SassyDice/RF-Controlled-Robotic-Hand/README.md

# RF Controlled Robotic Hand
 Created for school project using inmoov 3d models. All the necessary explanations are available in the files.
# *
# *
# RF Kontrollü Robotik El
 Inmoov 3d modelleri kullanılarak okul projesi için oluşturuldu. Gerekli tüm açıklamalar dosyalarda mevcuttur.
