SassyDice/RF-Controlled-Robotic-Hand/#Robotic Hand/3D Tasarım/Stl Dosyaları/#Dönebilen Bilek (Alternatif)/rotawrist3V2.stl

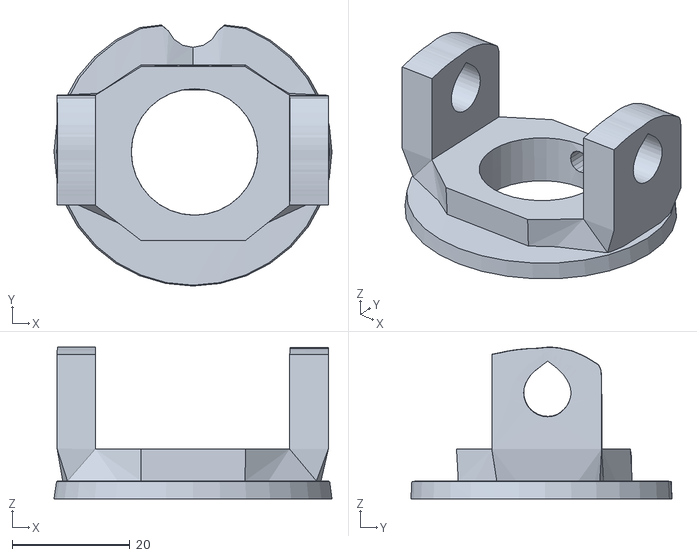
[picture p26: CAD file, 2021-06-02]
#Robotic Hand/3D Tasarım/Stl Dosyaları/#Dönebilen Bilek (Alternatif)/rotawrist3V2.stl
47.2 x 44.3 x 25.7
