SassyDice/RF-Controlled-Robotic-Hand/#Robotic Hand/3D Tasarım/Stl Dosyaları/Avuç İçi/WristlargeV4.stl

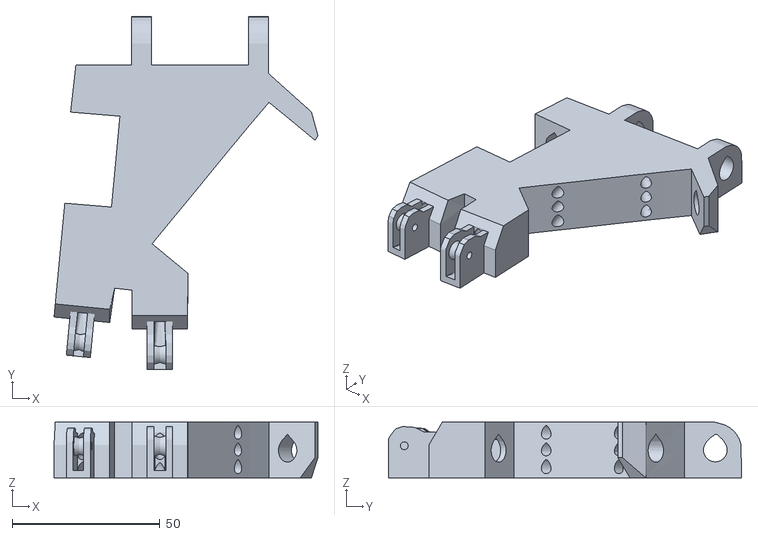
[picture p27: CAD file, 2021-06-02]
#Robotic Hand/3D Tasarım/Stl Dosyaları/Avuç İçi/WristlargeV4.stl
89.2 x 119.4 x 18.9
