SassyDice/RF-Controlled-Robotic-Hand/#Robotic Hand/3D Tasarım/Stl Dosyaları/Dış Kaplama/coverfinger1.stl

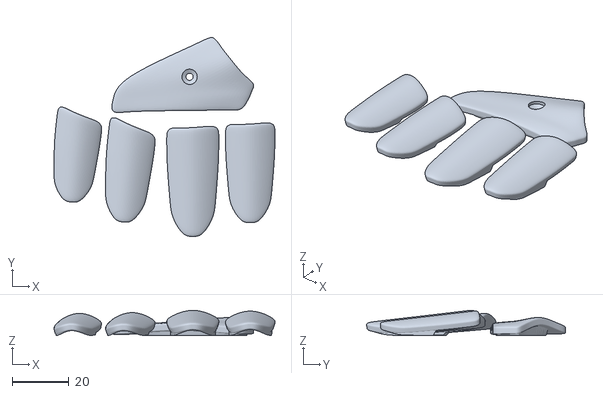
[picture p28: CAD file, 2021-06-02]
#Robotic Hand/3D Tasarım/Stl Dosyaları/Dış Kaplama/coverfinger1.stl
77.7 x 69.9 x 8.87
