SassyDice/RF-Controlled-Robotic-Hand/#Robotic Hand/3D Tasarım/Stl Dosyaları/Kol/robpart4V3.stl

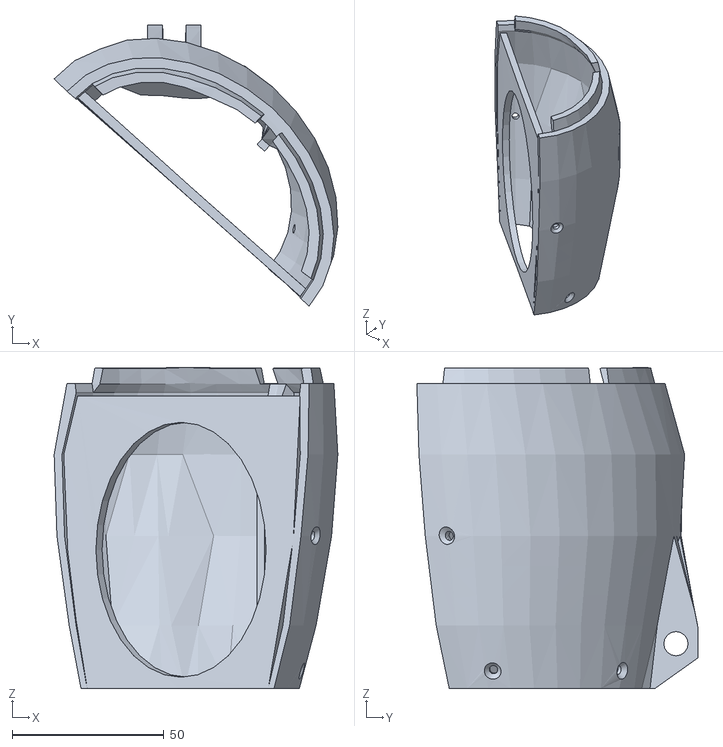
[picture p29: CAD file, 2021-06-02]
#Robotic Hand/3D Tasarım/Stl Dosyaları/Kol/robpart4V3.stl
93.5 x 92.7 x 105.8
