SassyDice/RF-Controlled-Robotic-Hand/#Robotic Hand/3D Tasarım/Stl Dosyaları/Parmaklar/Majeure3.stl

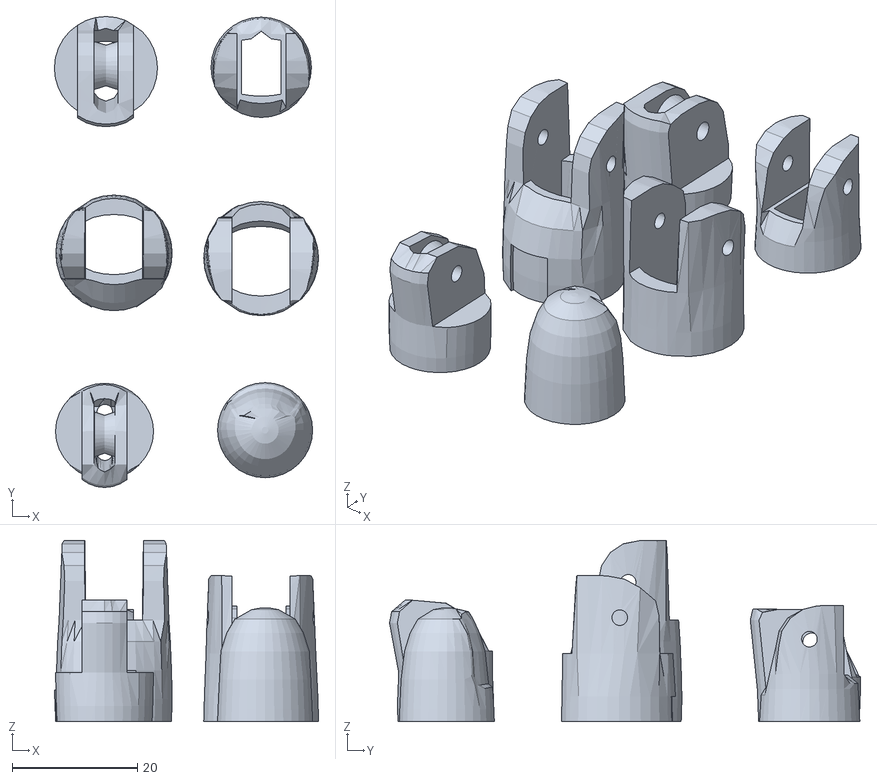
[picture p30: CAD file, 2021-06-02]
#Robotic Hand/3D Tasarım/Stl Dosyaları/Parmaklar/Majeure3.stl
42.2 x 75.2 x 29.0
