SassyDice/RF-Controlled-Robotic-Hand/#Robotic Hand/3D Tasarım/Stl Dosyaları/Çevre Birimler/RobCableBack.stl

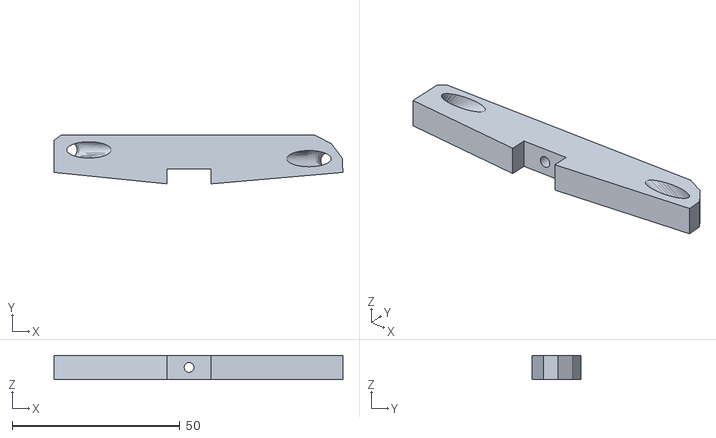
[picture p31: CAD file, 2021-06-02]
#Robotic Hand/3D Tasarım/Stl Dosyaları/Çevre Birimler/RobCableBack.stl
86.1 x 14.5 x 7.17
