SassyDice/RF-Controlled-Robotic-Hand/#Robotic Hand/3D Tasarım/Stl Dosyaları/#Dönebilen Bilek (Alternatif)/WristGearsV4.stl

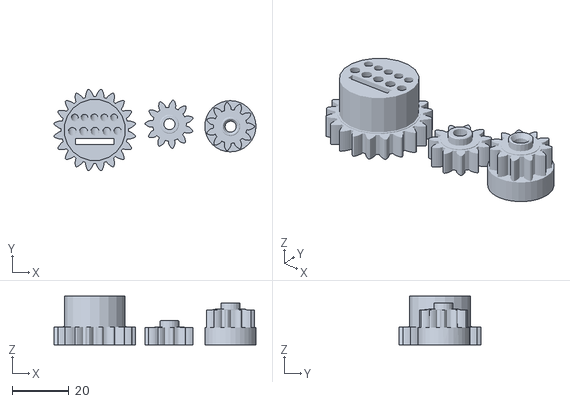
[picture p32: CAD file, 2021-06-02]
#Robotic Hand/3D Tasarım/Stl Dosyaları/#Dönebilen Bilek (Alternatif)/WristGearsV4.stl
71.0 x 28.7 x 17.1
