SassyDice/RF-Controlled-Robotic-Hand/#Robotic Hand/3D Tasarım/Stl Dosyaları/Avuç İçi/WristsmallV3.stl

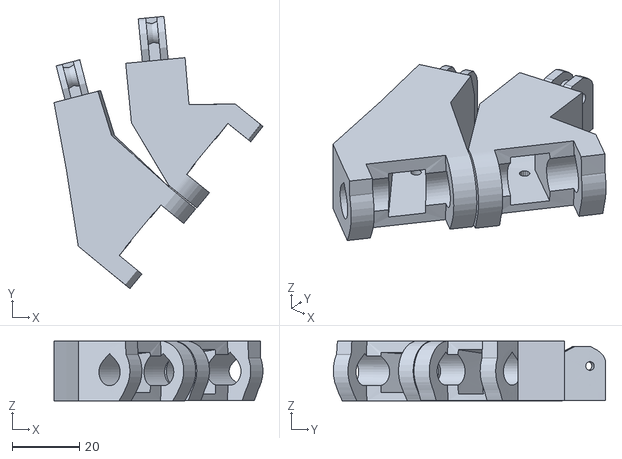
[picture p33: CAD file, 2021-06-02]
#Robotic Hand/3D Tasarım/Stl Dosyaları/Avuç İçi/WristsmallV3.stl
62.0 x 80.8 x 17.7
