SassyDice/RF-Controlled-Robotic-Hand/#Robotic Hand/3D Tasarım/Stl Dosyaları/Dış Kaplama/topsurface4.stl

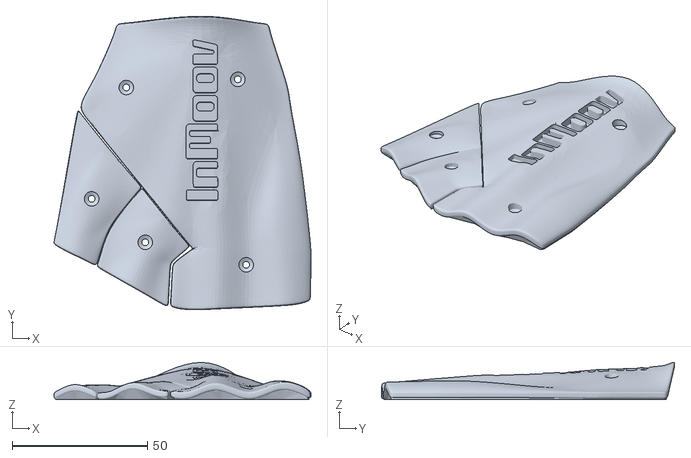
[picture p34: CAD file, 2021-06-02]
#Robotic Hand/3D Tasarım/Stl Dosyaları/Dış Kaplama/topsurface4.stl
94.9 x 108.3 x 13.7
