SassyDice/RF-Controlled-Robotic-Hand/#Robotic Hand/3D Tasarım/Stl Dosyaları/Kol/robpart3V3.stl

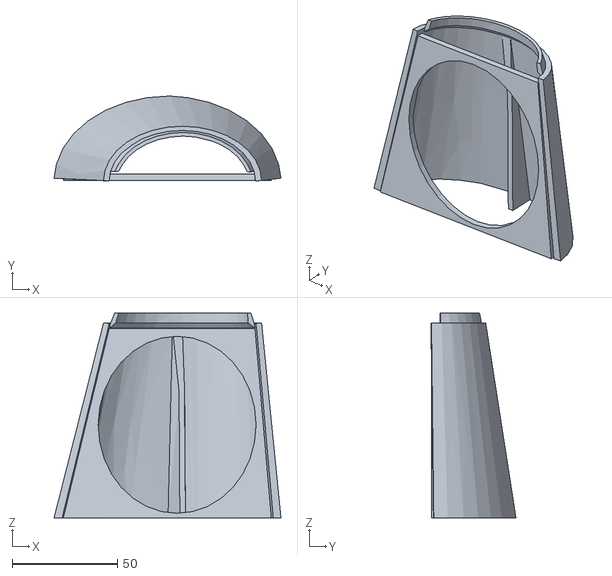
[picture p35: CAD file, 2021-06-02]
#Robotic Hand/3D Tasarım/Stl Dosyaları/Kol/robpart3V3.stl
107.8 x 40.4 x 97.3
