SassyDice/RF-Controlled-Robotic-Hand/#Robotic Hand/3D Tasarım/Stl Dosyaları/Parmaklar/Auriculaire3.stl

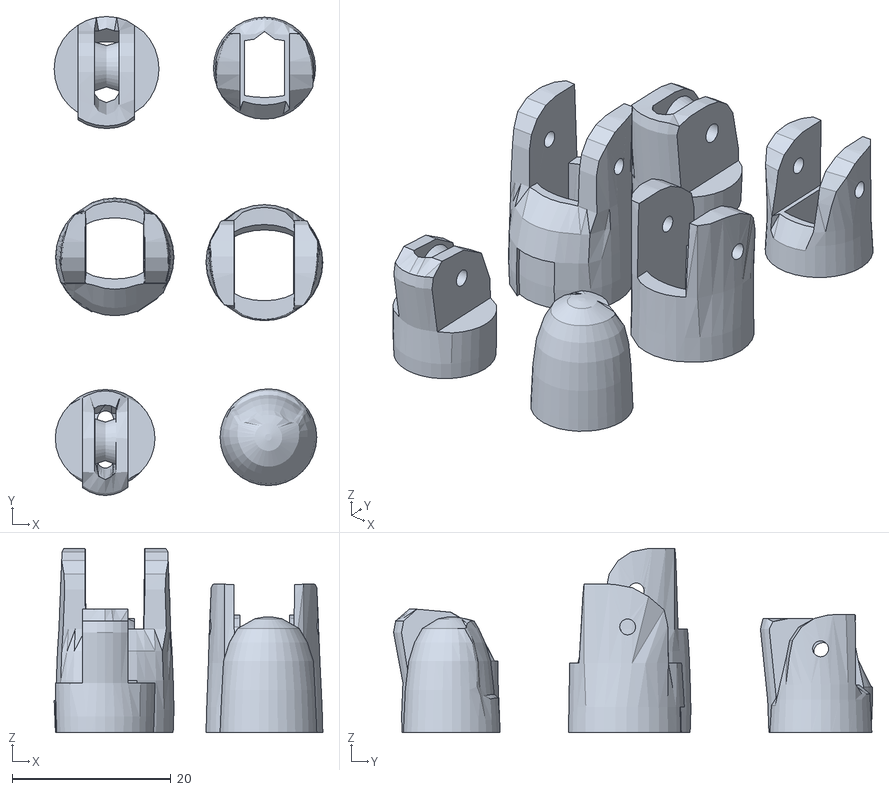
[picture p36: CAD file, 2021-06-02]
#Robotic Hand/3D Tasarım/Stl Dosyaları/Parmaklar/Auriculaire3.stl
33.8 x 60.3 x 23.2
