SassyDice/RF-Controlled-Robotic-Hand/#Robotic Hand/3D Tasarım/Stl Dosyaları/Çevre Birimler/RobRing.stl

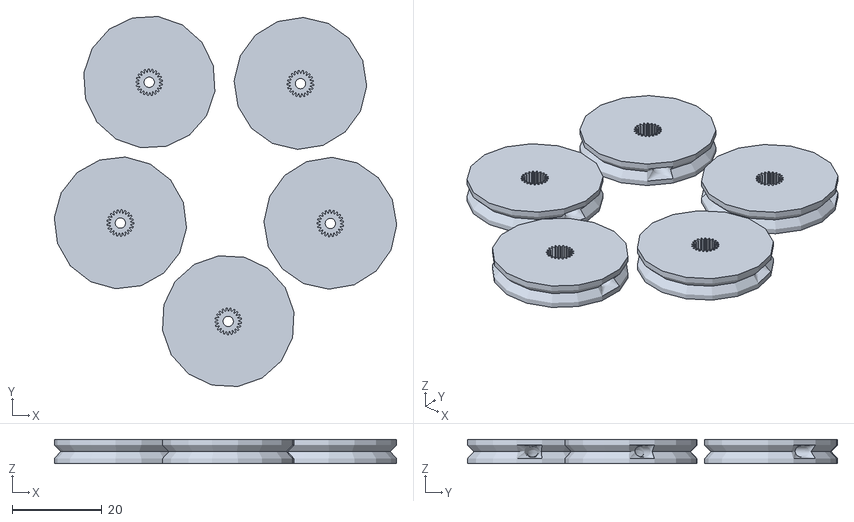
[picture p37: CAD file, 2021-06-02]
#Robotic Hand/3D Tasarım/Stl Dosyaları/Çevre Birimler/RobRing.stl
76.1 x 82.3 x 5.37
