SassyDice/RF-Controlled-Robotic-Hand/#Robotic Hand/3D Tasarım/Stl Dosyaları/#Dönebilen Bilek (Alternatif)/rotawrist1V3.stl

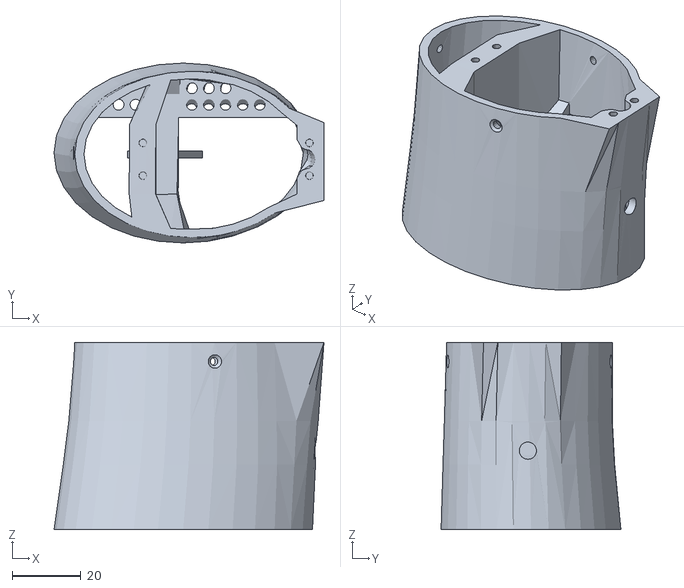
[picture p38: CAD file, 2021-06-02]
#Robotic Hand/3D Tasarım/Stl Dosyaları/#Dönebilen Bilek (Alternatif)/rotawrist1V3.stl
78.4 x 52.2 x 54.4
