SassyDice/RF-Controlled-Robotic-Hand/#Robotic Hand/3D Tasarım/Stl Dosyaları/Kol/robpart2V3.stl

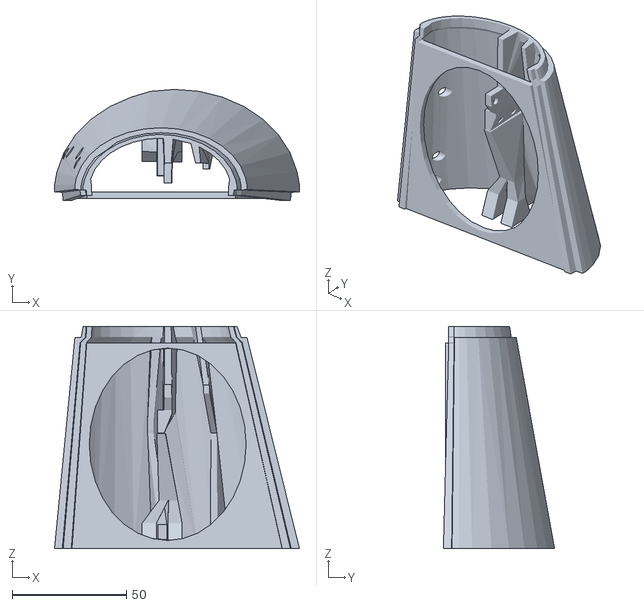
[picture p39: CAD file, 2021-06-02]
#Robotic Hand/3D Tasarım/Stl Dosyaları/Kol/robpart2V3.stl
107.2 x 48.7 x 97.3
