SassyDice/RF-Controlled-Robotic-Hand/#Robotic Hand/3D Tasarım/Stl Dosyaları/Parmaklar/ringfinger3.stl

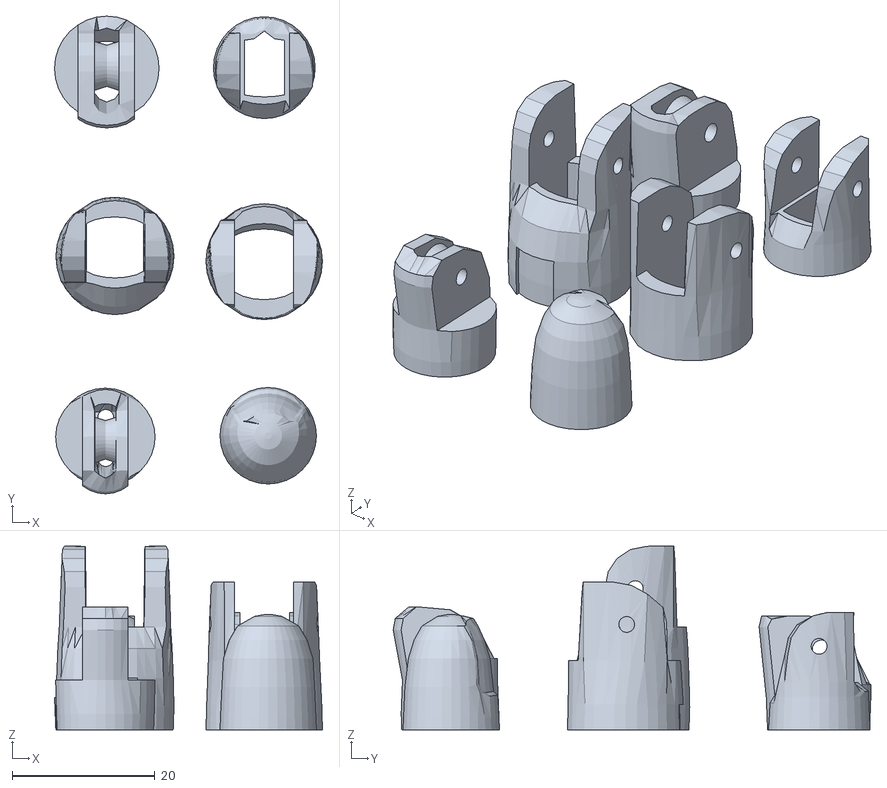
[picture p40: CAD file, 2021-06-02]
#Robotic Hand/3D Tasarım/Stl Dosyaları/Parmaklar/ringfinger3.stl
37.6 x 67.0 x 25.8
