SassyDice/RF-Controlled-Robotic-Hand/#Robotic Hand/3D Tasarım/Stl Dosyaları/Çevre Birimler/ardiuinosupport.stl

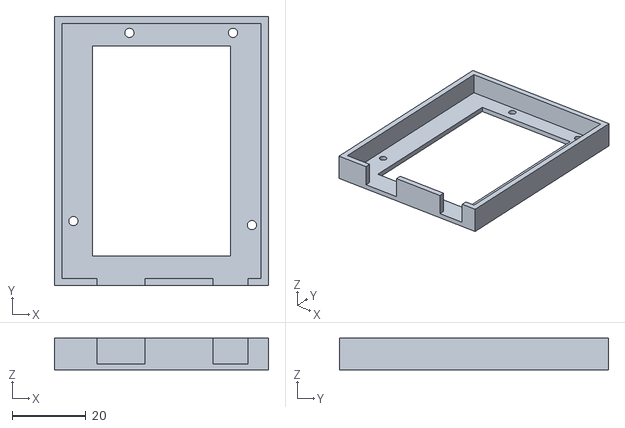
[picture p41: CAD file, 2021-06-02]
#Robotic Hand/3D Tasarım/Stl Dosyaları/Çevre Birimler/ardiuinosupport.stl
58.0 x 73.0 x 8.62
