SassyDice/RF-Controlled-Robotic-Hand/#Robotic Hand/3D Tasarım/Stl Dosyaları/#Dönebilen Bilek (Alternatif)/..robpart1V2 (Non-rotationable).stl

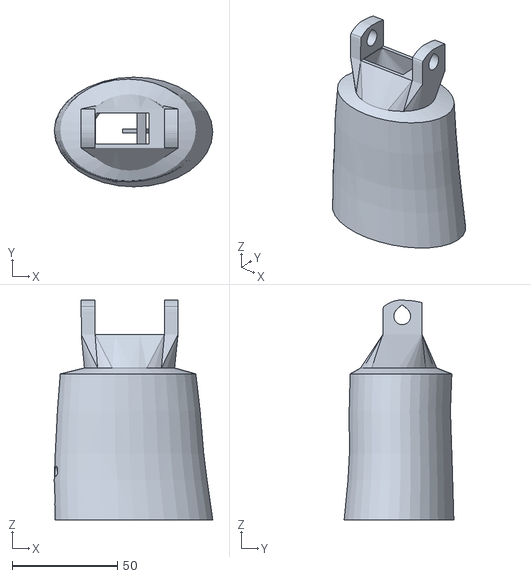
[picture p42: CAD file, 2021-06-02]
#Robotic Hand/3D Tasarım/Stl Dosyaları/#Dönebilen Bilek (Alternatif)/..robpart1V2 (Non-rotationable).stl
75.5 x 52.2 x 104.7
