SassyDice/RF-Controlled-Robotic-Hand/#Robotic Hand/3D Tasarım/Stl Dosyaları/Kol/robpart5V3.stl

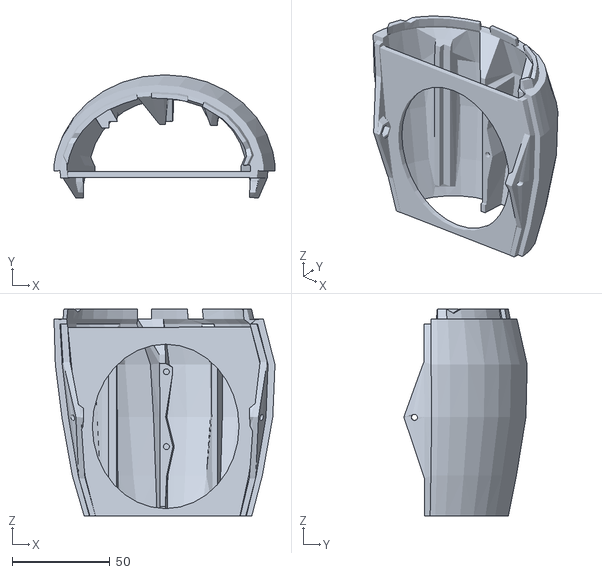
[picture p43: CAD file, 2021-06-02]
#Robotic Hand/3D Tasarım/Stl Dosyaları/Kol/robpart5V3.stl
113.0 x 63.1 x 105.7
