SassyDice/RF-Controlled-Robotic-Hand/#Robotic Hand/3D Tasarım/Stl Dosyaları/Parmaklar/thumb5.stl

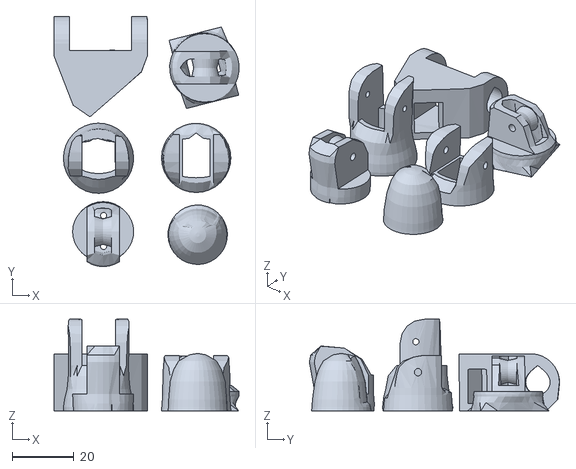
[picture p44: CAD file, 2021-06-02]
#Robotic Hand/3D Tasarım/Stl Dosyaları/Parmaklar/thumb5.stl
60.1 x 81.2 x 29.8
