SassyDice/RF-Controlled-Robotic-Hand/#Robotic Hand/3D Tasarım/Stl Dosyaları/#Dönebilen Bilek (Alternatif)/cableholderwristV4.stl

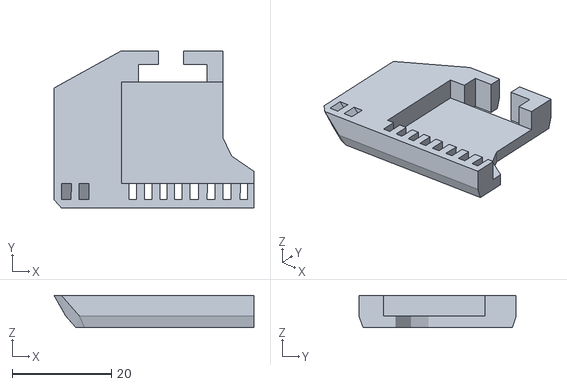
[picture p45: CAD file, 2021-06-02]
#Robotic Hand/3D Tasarım/Stl Dosyaları/#Dönebilen Bilek (Alternatif)/cableholderwristV4.stl
40.2 x 31.6 x 6.44
