SassyDice/RF-Controlled-Robotic-Hand/#Robotic Hand/3D Tasarım/Stl Dosyaları/Kol/robcap3V1.stl

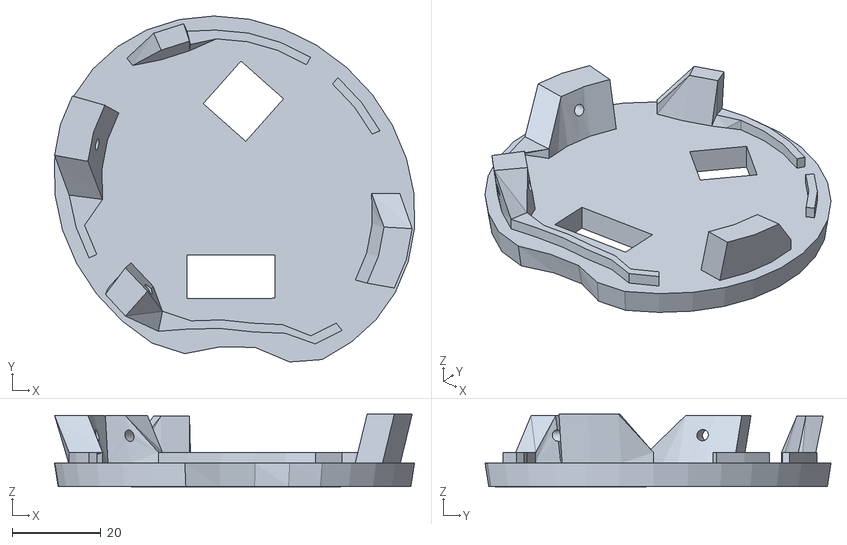
[picture p46: CAD file, 2021-06-02]
#Robotic Hand/3D Tasarım/Stl Dosyaları/Kol/robcap3V1.stl
81.4 x 78.2 x 16.4
