SassyDice/RF-Controlled-Robotic-Hand/#Robotic Hand/3D Tasarım/Stl Dosyaları/Parmaklar/Index3.stl

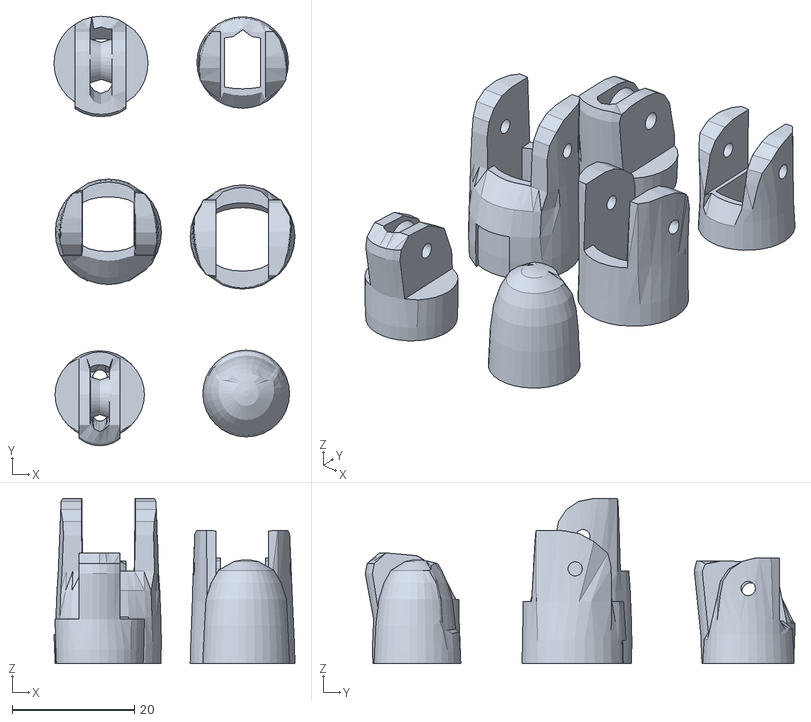
[picture p47: CAD file, 2021-06-02]
#Robotic Hand/3D Tasarım/Stl Dosyaları/Parmaklar/Index3.stl
39.4 x 70.2 x 27.0
