SassyDice/RF-Controlled-Robotic-Hand/#Robotic Hand/3D Tasarım/Stl Dosyaları/Çevre Birimler/RobServoBed.stl

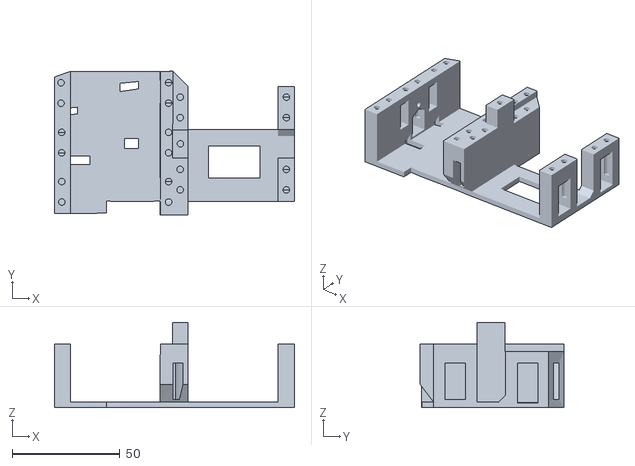
[picture p48: CAD file, 2021-06-02]
#Robotic Hand/3D Tasarım/Stl Dosyaları/Çevre Birimler/RobServoBed.stl
111.6 x 66.7 x 39.7
