SassyDice/RF-Controlled-Robotic-Hand/#Robotic Hand/3D Tasarım/Stl Dosyaları/Çevre Birimler/RobCableFront.stl

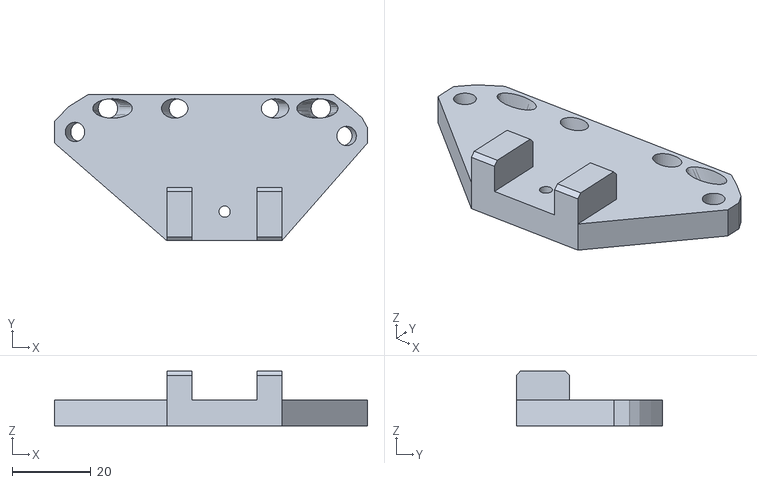
[picture p50: CAD file, 2021-06-02]
#Robotic Hand/3D Tasarım/Stl Dosyaları/Çevre Birimler/RobCableFront.stl
79.3 x 37.1 x 13.8
