SassyDice/RF-Controlled-Robotic-Hand/(list of files, cad)

Other CAD files:
#Robotic Hand/3D Tasarım/Stl Dosyaları/Çevre Birimler/Bolt_entretoise7.stl
